colefr/vfdproject/src/segment_bits.pdf

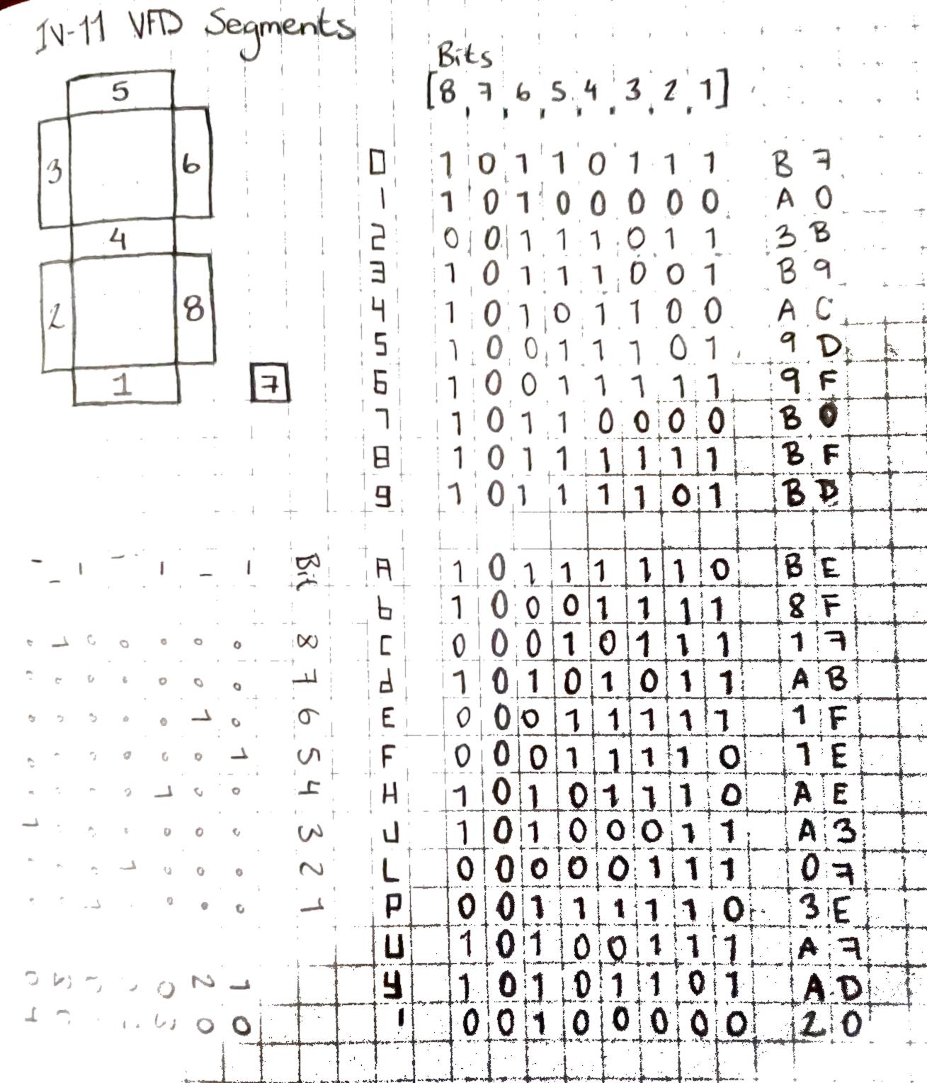
[picture p8: page 1]
