colefr/vfdproject/src/board_3dview.jpg

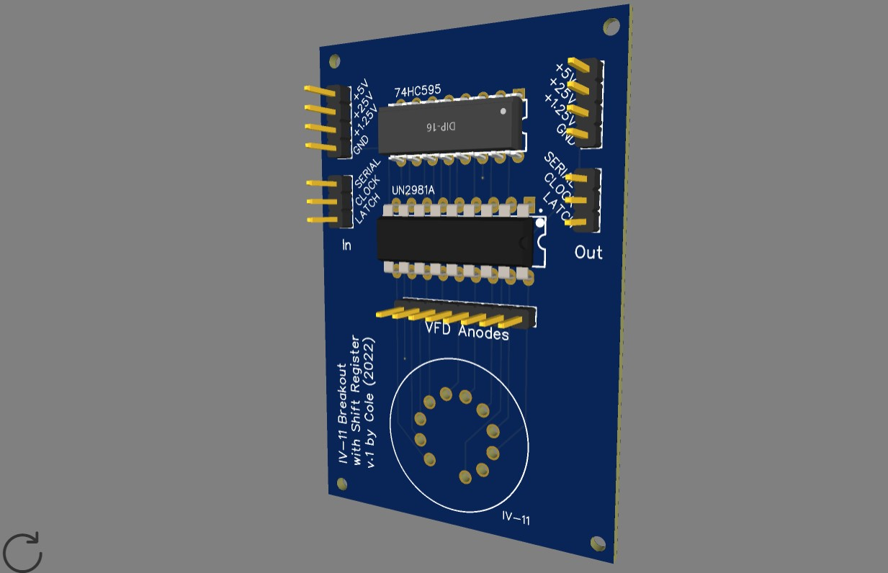
src/board_3dview.jpg
