colefr/vfdproject/src/Schematic_IV-11 VFD.pdf

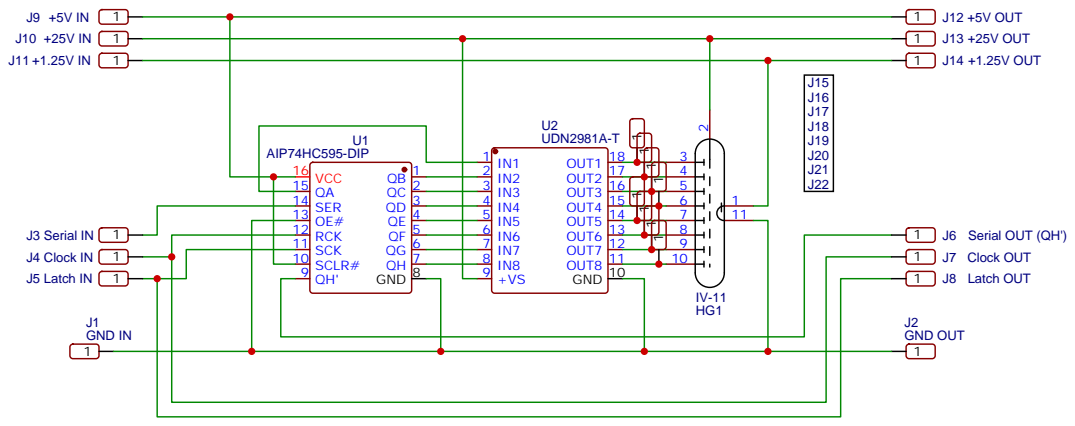
[picture p10: page 1]

AIP74HC595-DIP
OE# 13 SER 14 QA 15 VCC 16

Drawn By: Cole Frauzel
