colefr/vfdproject/src/PCB_BottomLayer.pdf

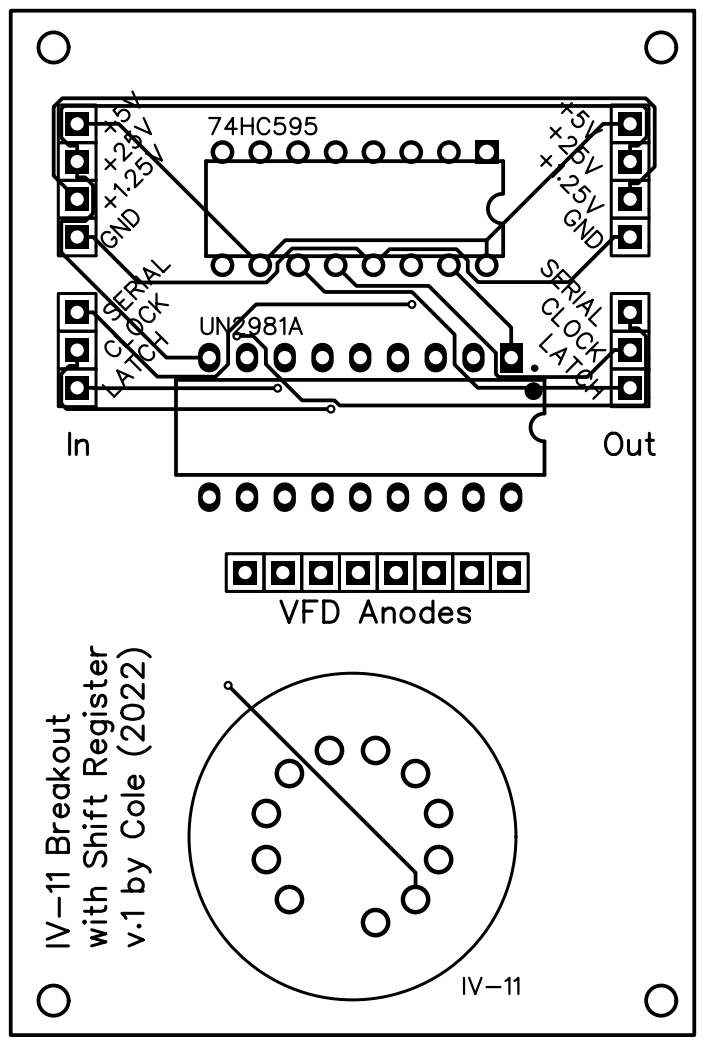
[picture p11: page 1]
