colefr/vfdproject/src/PCB_TopLayer.pdf

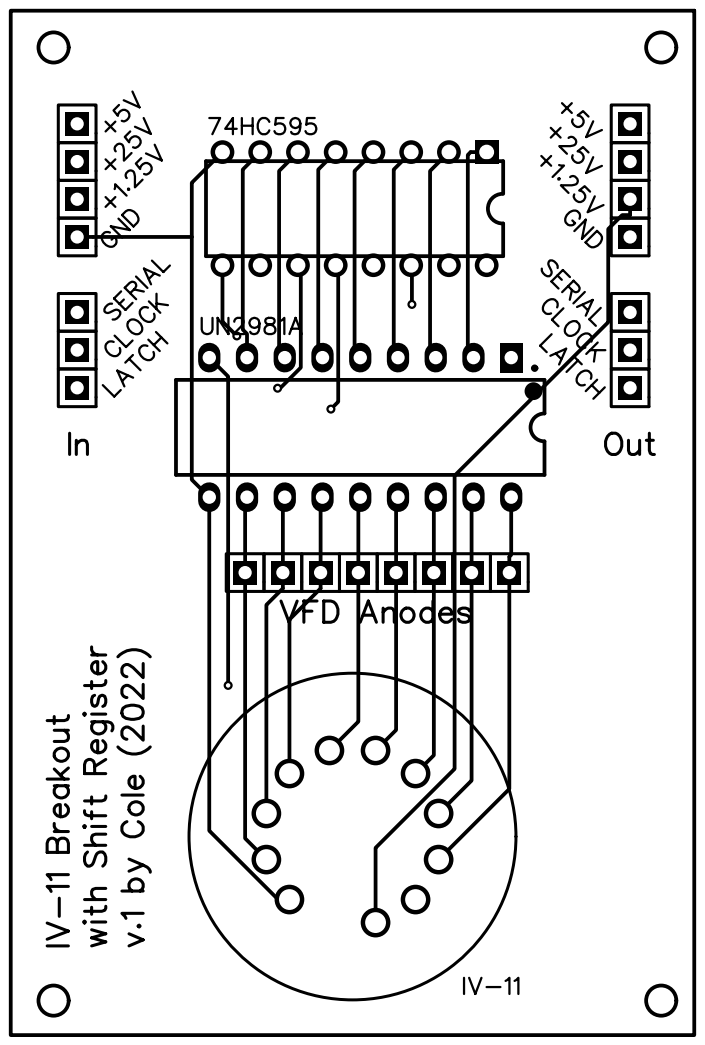
[picture p12: page 1]
